ese-519/Xblocks/README.md

AtomWire
============

**University of Pennsylvania, ESE 519: Real Time and Embedded Systems**

* Siri Anil, Sana Kamboj, Sarvesh Patkar
* [Blog](https://devpost.com/software/atomwire) 

### [Demo](https://youtu.be/rHM-RSoe9MM)

### Chess
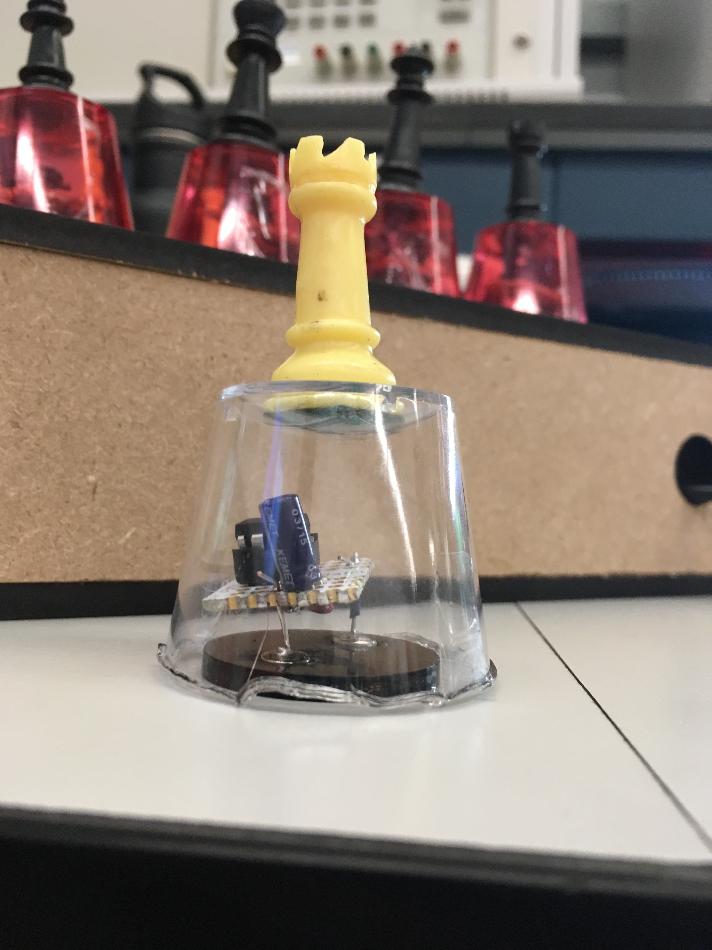
[picture p1: images/Chess.jpg]


### Tower of Hanoi
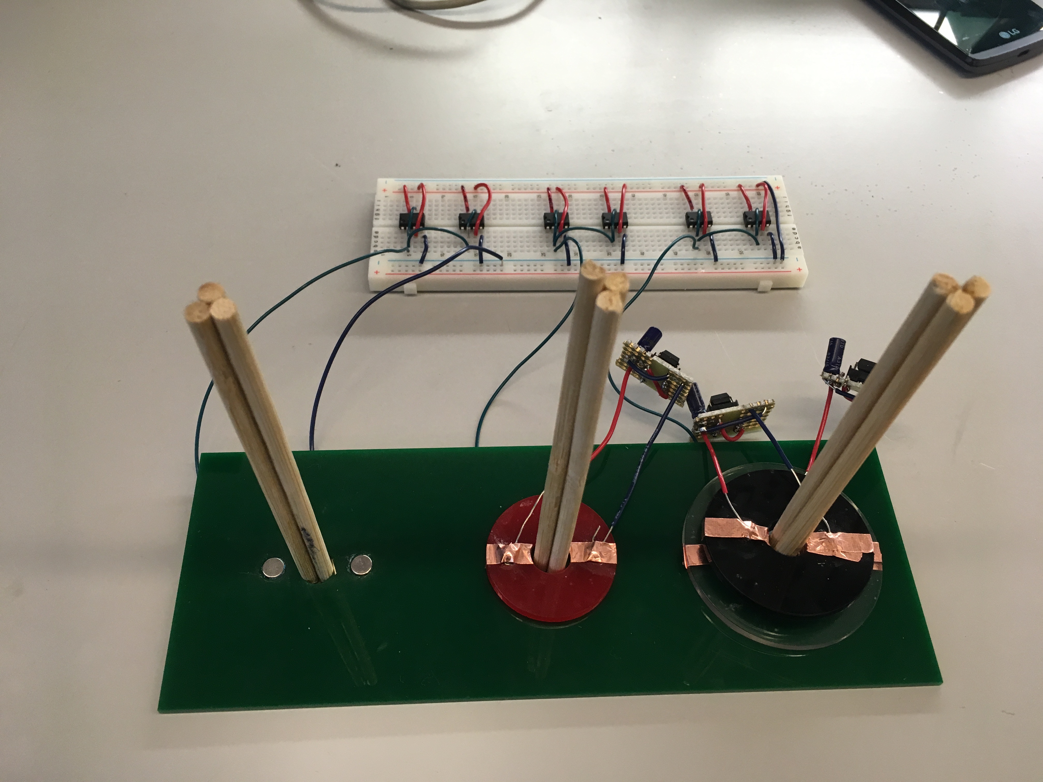
[picture p2: images/Towers.jpg]


### Instructions
Please follow the instructions in the report to run the system
