ese-519/Xblocks/Unity Games/README.md

Unity Game
============

# Prerequisites

* Windows PC
* Unity 5.4.3f1
* Successful connection of Arduino to a COM port on PC

## Running

* Open Unity and find the project. 
* Press the play button.
* If it doesn't work, check the COM Port and edit the Script accordingly
