ese-519/Xblocks/Unity Games/Demo/Assets/Materials/download (1).jpg

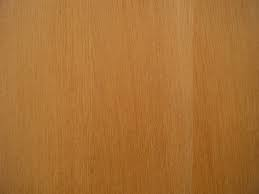
Unity Games/Demo/Assets/Materials/download (1).jpg
