ese-519/Xblocks/Mechanical Parts/SolidWorks_519/AcrylicBase.SLDASM

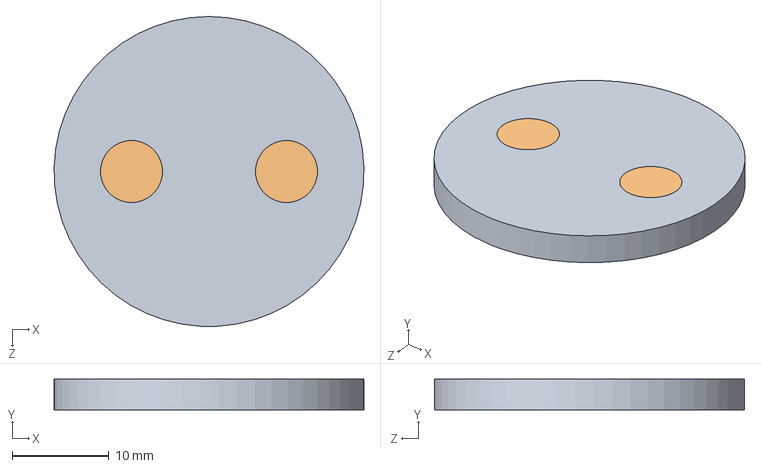
[picture p23: CAD file, 2016-12-21]
Mechanical Parts/SolidWorks_519/AcrylicBase.SLDASM
32.0 x 3.17 x 32.0 mm
Base
Magnet x 2
