ese-519/Xblocks/Mechanical Parts/SolidWorks_519/Magnet.SLDPRT

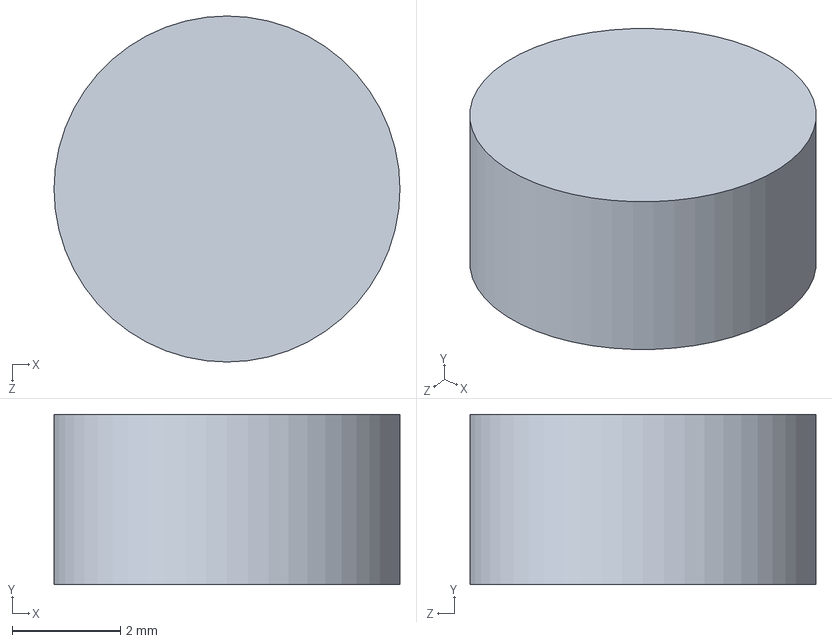
[picture p24: CAD file, 2016-12-21]
Mechanical Parts/SolidWorks_519/Magnet.SLDPRT
6.40 x 3.15 x 6.40 mm
