ese-519/Xblocks/Mechanical Parts/SolidWorks_519/Base.SLDPRT

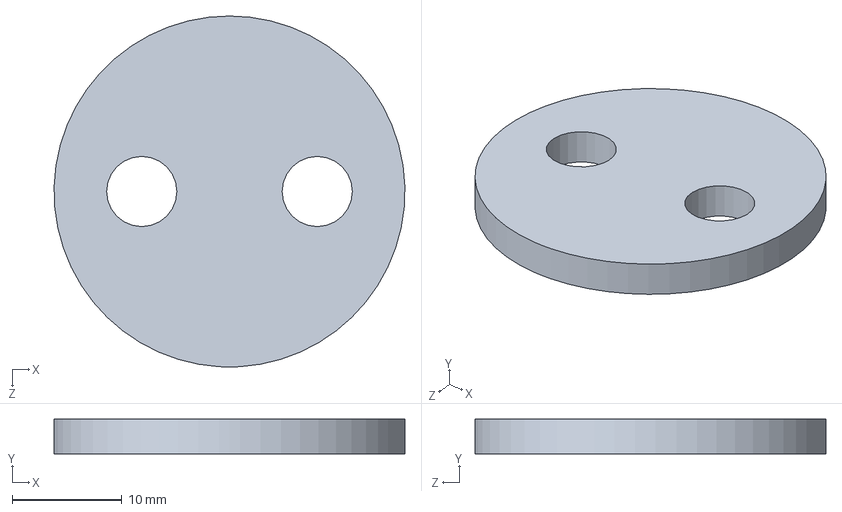
[picture p25: CAD file, 2016-12-21]
Mechanical Parts/SolidWorks_519/Base.SLDPRT
32.0 x 3.17 x 32.0 mm
