ese-519/Xblocks/Circuit Diagrams and Schematics/Eagle_519/519_sch.brd

## EAGLE design Circuit Diagrams and Schematics/Eagle_519/519_sch.brd (2016-12-21)

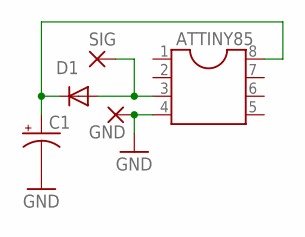
[picture p26: schematic 519_sch.sch]

Parts:
ATTINY85: DIL8; DIL08
C1: CPOL-USE2,5-6E; E2,5-6E
D1: 1N4148DO35-7; DO35-7
GND: 3,81/1,4
SIG: 3,81/1,4

Connections:
GND: ATTINY85.4, C1.-, GND.1
unnamed: ATTINY85.8, C1.+, D1.C
unnamed: ATTINY85.3, D1.A, SIG.1

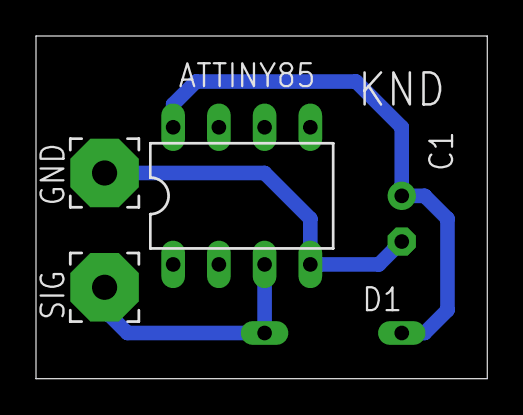
[picture p27: board 519_sch.brd from above]

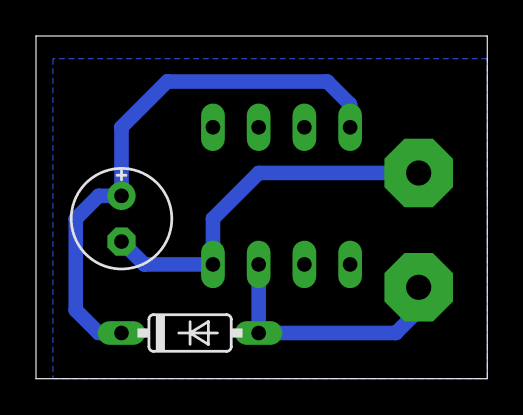
[picture p28: board 519_sch.brd from below]

Board: 2 copper layers, 25.1 x 19.0 mm, 5 parts (2 on the bottom side), 3 nets.
